MixMatchMLtoolkit/DIY-toolkit/sensing board/schematic.pdf

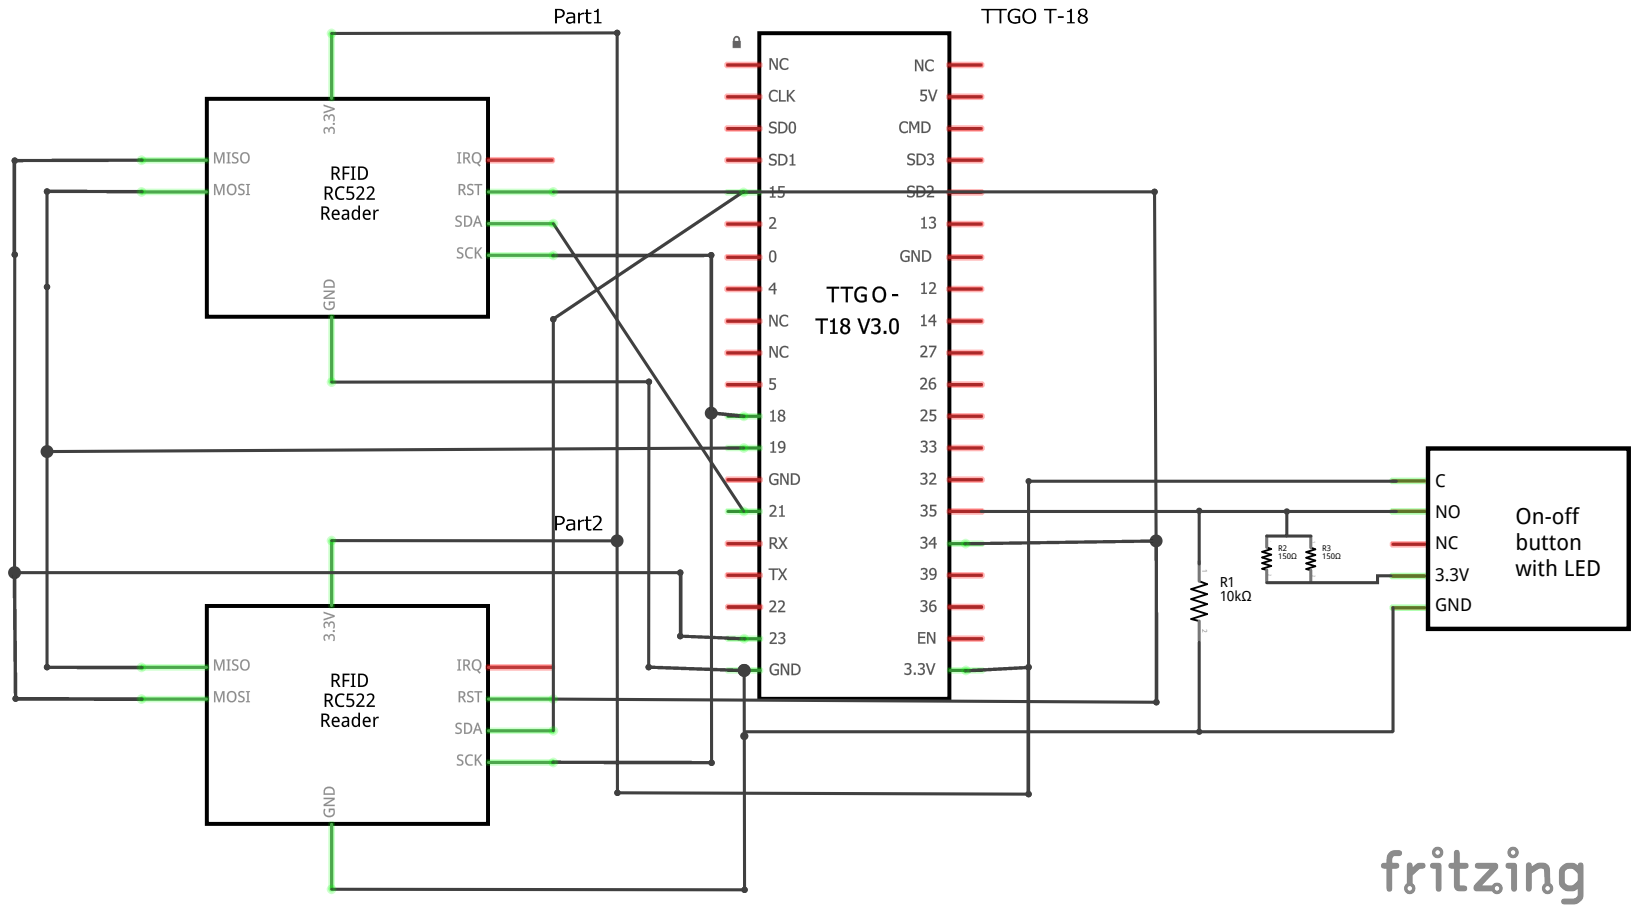
[picture p3: page 1]
On-off button with LED; C NO NC 3.3V GND
