MixMatchMLtoolkit/DIY-toolkit/sensing board/assembling tokens.jpg

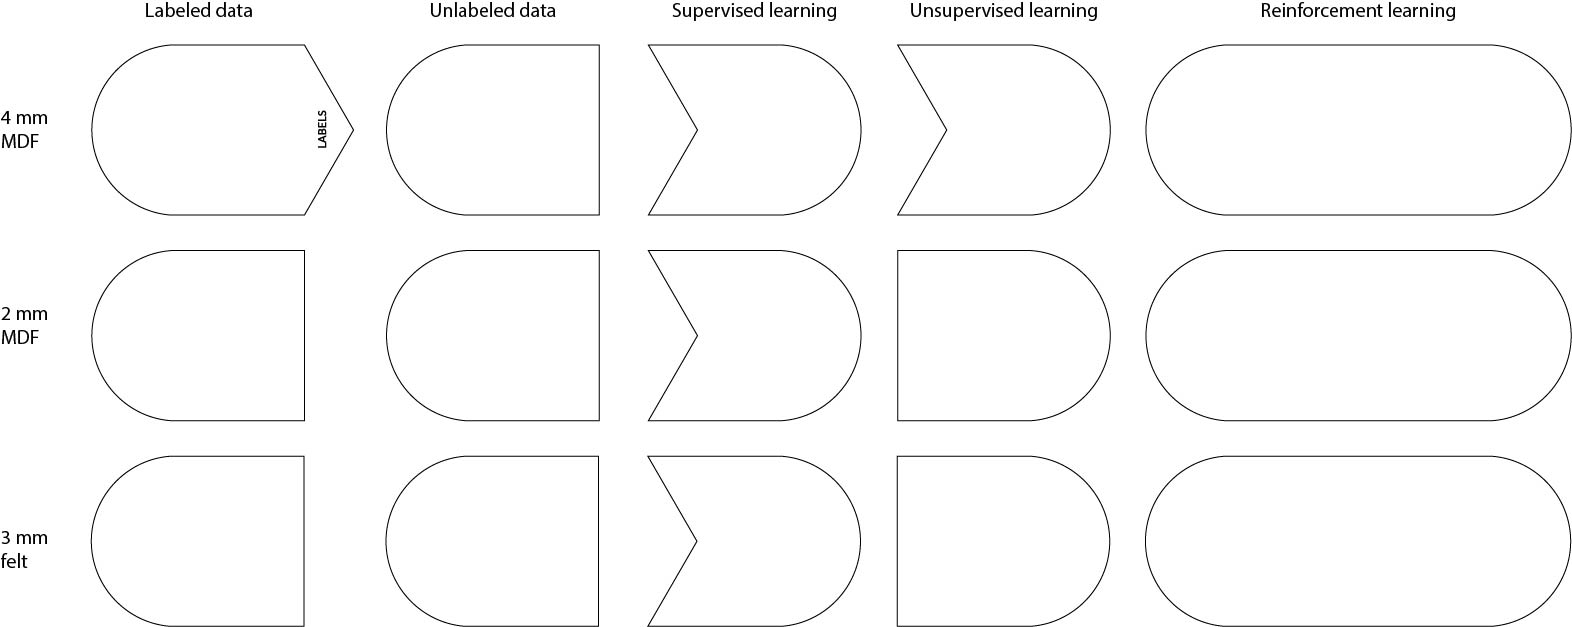
sensing board/assembling tokens.jpg
