MixMatchMLtoolkit/DIY-toolkit/(commit log)

2022-11-18 Files and code
    [Token id's.xlsx]
2022-11-18 Update image
    Change sensor to sensing
2022-11-23 changes in lasercut files
2024-03-04 Lasercut settings
